Luker373/OST/CAD_Files/PotFitPieceCheapV3.SLDPRT

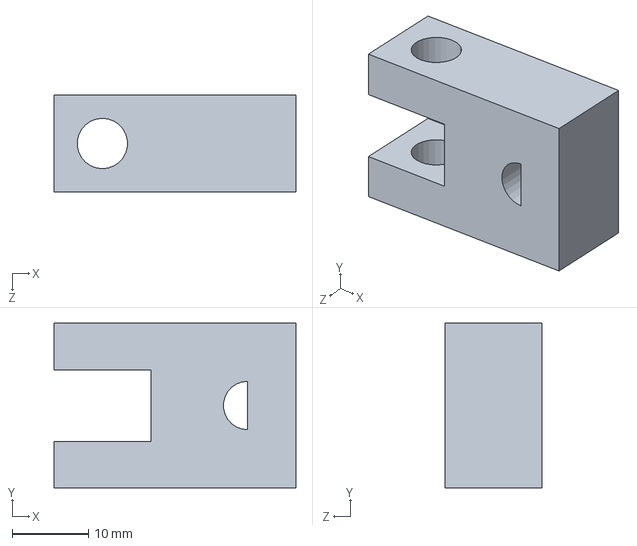
[picture p56: CAD file, 2019-04-29]
CAD_Files/PotFitPieceCheapV3.SLDPRT
31.8 x 21.6 x 12.7 mm
