Luker373/OST/CAD_Files/BoomSlotPieceConstrained.SLDPRT

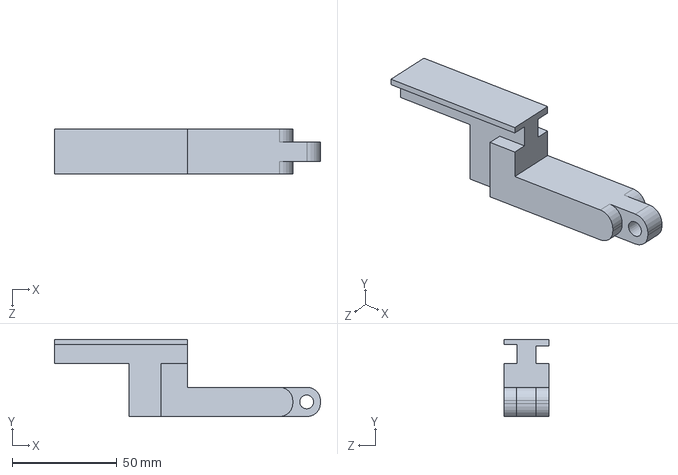
[picture p57: CAD file, 2019-04-29]
CAD_Files/BoomSlotPieceConstrained.SLDPRT
127.0 x 36.8 x 21.6 mm
