Luker373/OST/CAD_Files/HalfMastMountRedoArc.SLDPRT

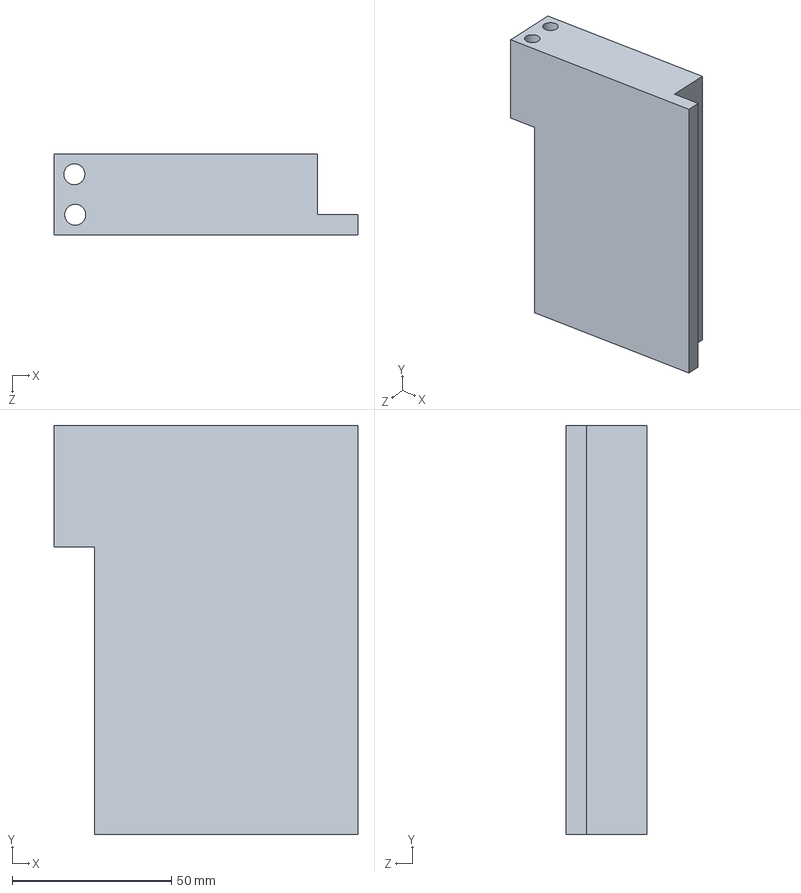
[picture p58: CAD file, 2019-02-09]
CAD_Files/HalfMastMountRedoArc.SLDPRT
95.2 x 128.3 x 25.4 mm
