Luker373/OST/CAD_Files/BoomHingePieceConstrained.SLDPRT

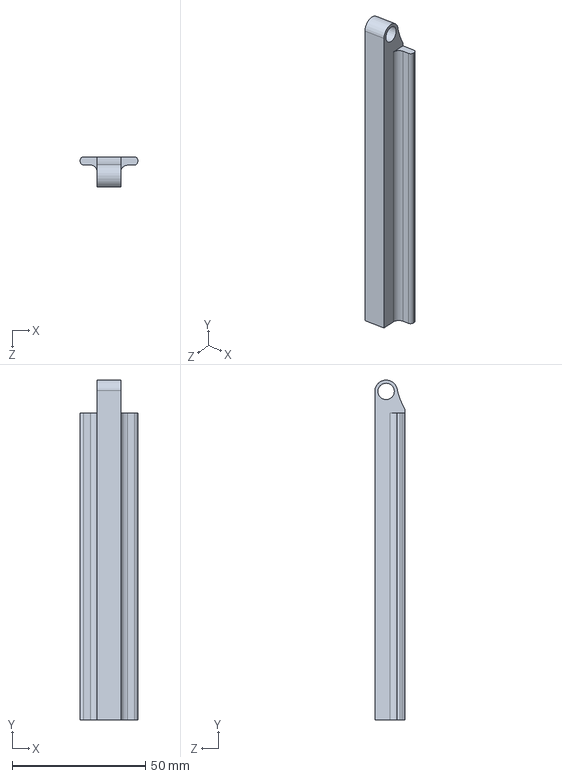
[picture p59: CAD file, 2019-02-08]
CAD_Files/BoomHingePieceConstrained.SLDPRT
21.6 x 127.5 x 11.4 mm
