Luker373/OST/CAD_Files/PotBoomRotTransferPartConstrained.SLDPRT

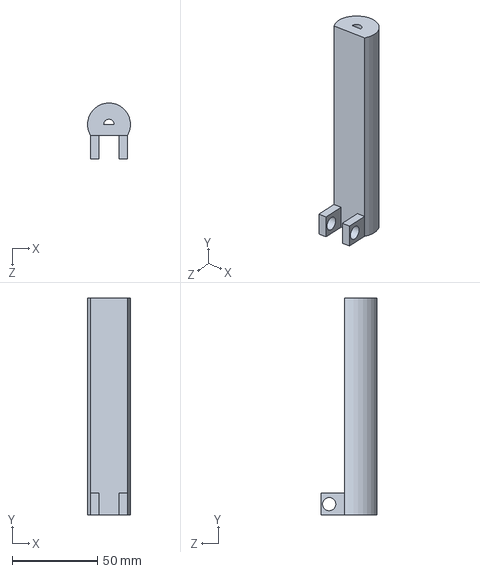
[picture p60: CAD file, 2019-02-08]
CAD_Files/PotBoomRotTransferPartConstrained.SLDPRT
25.1 x 127.3 x 32.7 mm
