Luker373/OST/CAD_Files/HalfMastMountV1.SLDPRT

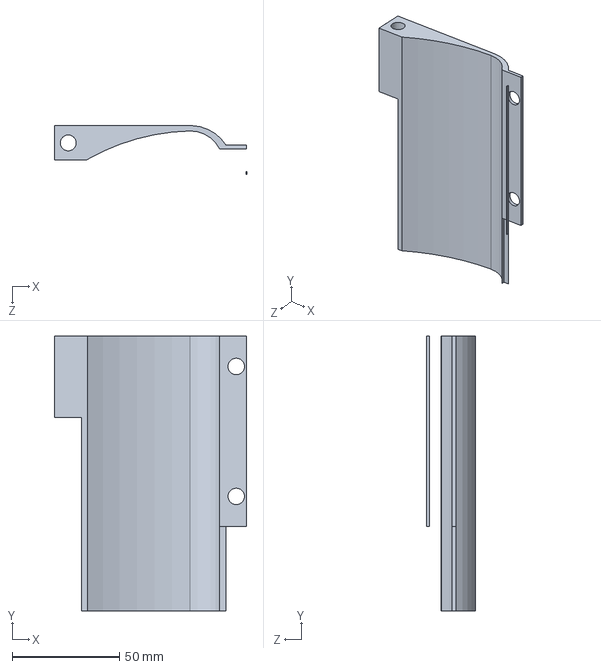
[picture p61: CAD file, 2019-02-07]
CAD_Files/HalfMastMountV1.SLDPRT
89.7 x 128.3 x 22.7 mm
