Luker373/OST/CAD_Files/PotBoomRotTransferPartV2.SLDPRT

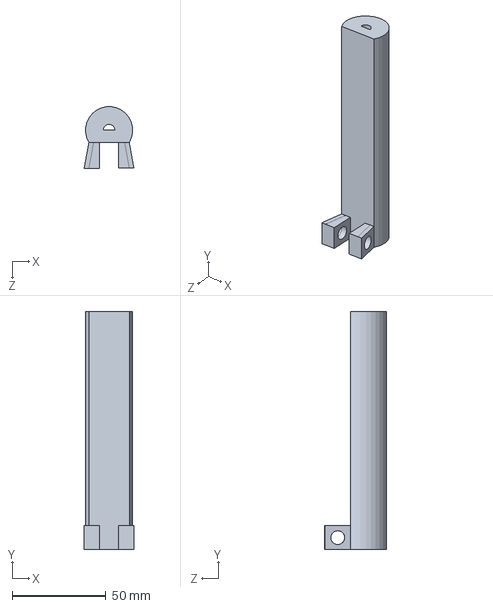
[picture p62: CAD file, 2019-01-29]
CAD_Files/PotBoomRotTransferPartV2.SLDPRT
26.6 x 127.3 x 32.9 mm
