Luker373/OST/CAD_Files/MastMountV2.SLDPRT

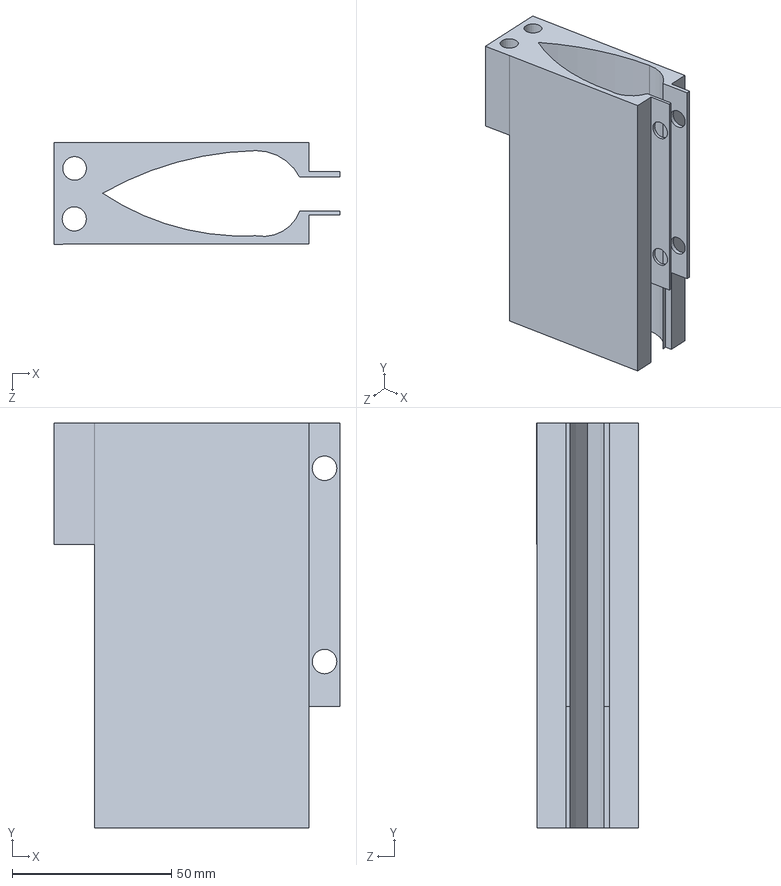
[picture p63: CAD file, 2019-01-29]
CAD_Files/MastMountV2.SLDPRT
89.7 x 127.0 x 31.9 mm
