Luker373/OST/CAD_Files/BoomHingePieceV2.SLDPRT

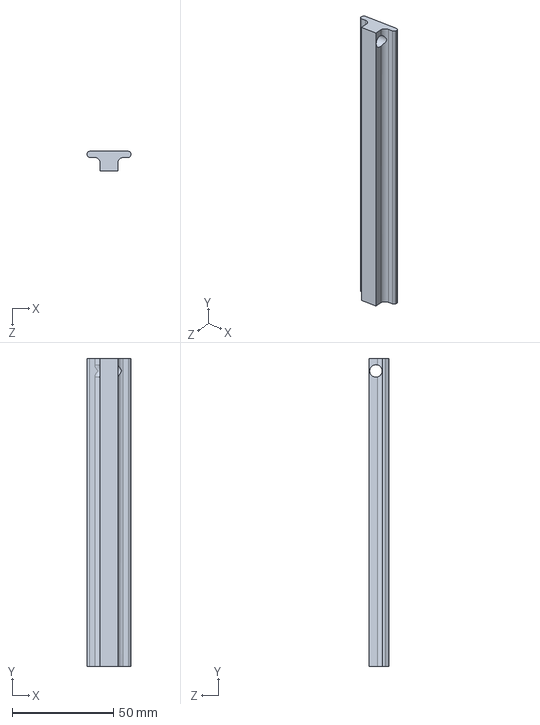
[picture p64: CAD file, 2019-01-29]
CAD_Files/BoomHingePieceV2.SLDPRT
21.6 x 152.4 x 9.67 mm
