Luker373/OST/CAD_Files/MastMountAirfoilPart.SLDPRT

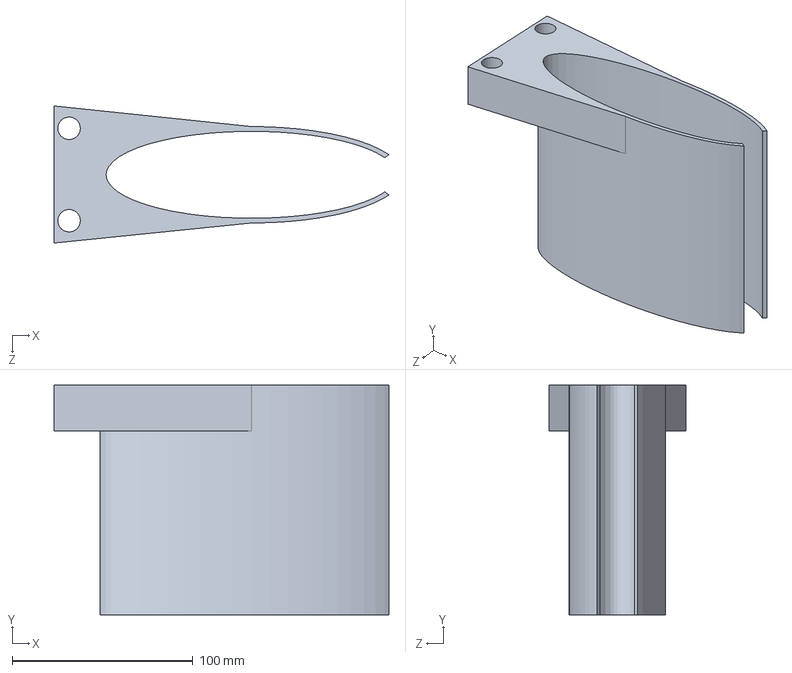
[picture p65: CAD file, 2019-01-22]
CAD_Files/MastMountAirfoilPart.SLDPRT
185.5 x 127.3 x 75.9 mm
