Luker373/OST/CAD_Files/MastMountFlatPart.SLDPRT

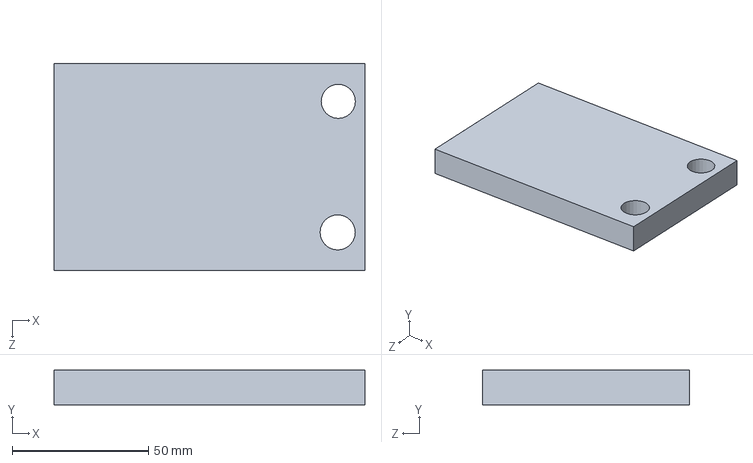
[picture p66: CAD file, 2019-01-22]
CAD_Files/MastMountFlatPart.SLDPRT
114.3 x 12.7 x 76.1 mm
