Luker373/OST/CAD_Files/BoomHingePiece.SLDPRT

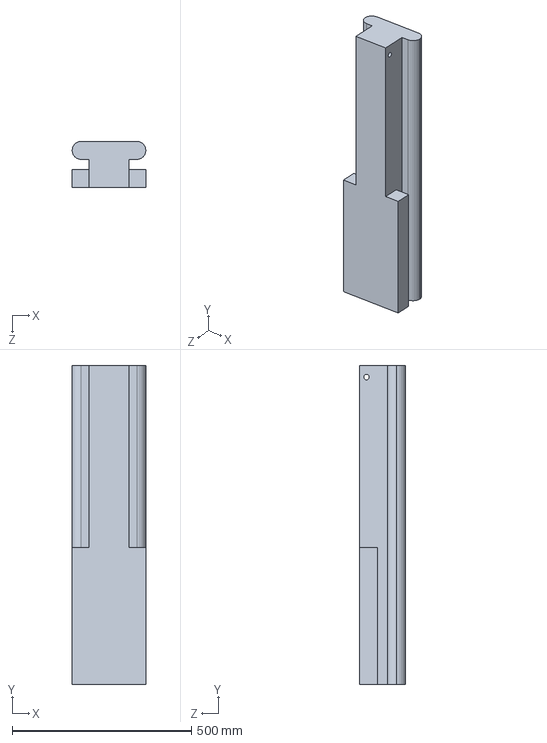
[picture p67: CAD file, 2019-01-25, an earlier design]
CAD_Files/BoomHingePiece.SLDPRT
205.8 x 889.5 x 129.5 mm
