Luker373/OST/CAD_Files/PotBoomRotTransferPart.SLDPRT

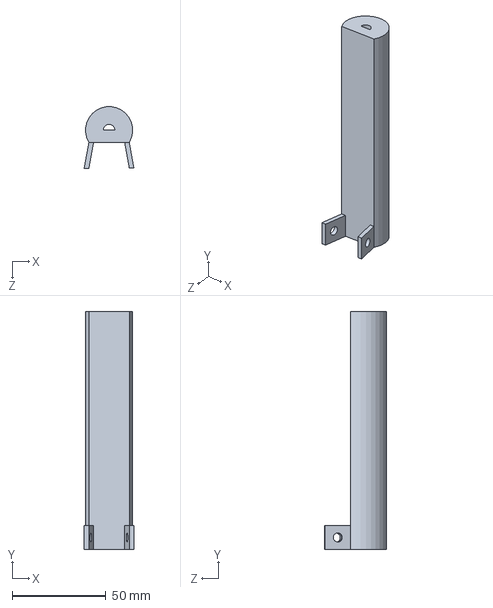
[picture p68: CAD file, 2019-01-22, an earlier design]
CAD_Files/PotBoomRotTransferPart.SLDPRT
26.6 x 127.3 x 32.9 mm
