Luker373/OST/CAD_Files/MastMountV1.SLDPRT

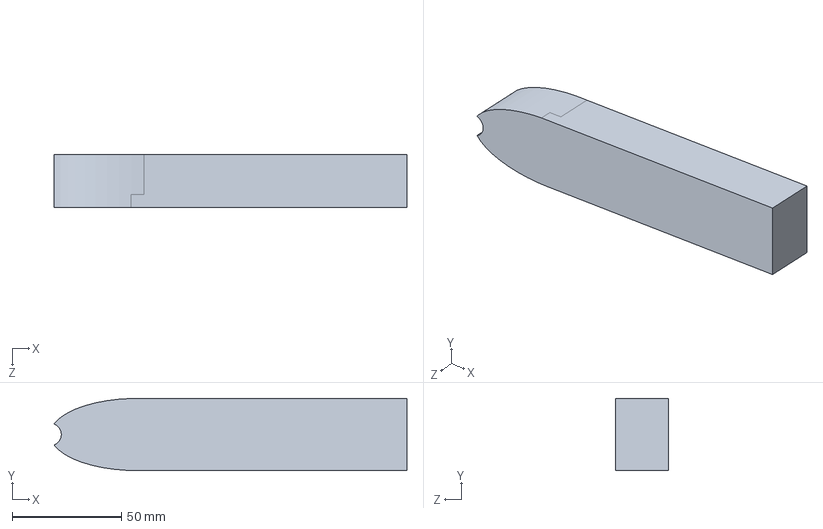
[picture p69: CAD file, 2019-01-18, an earlier design]
CAD_Files/MastMountV1.SLDPRT
161.8 x 33.1 x 24.1 mm
