Luker373/OST/MPLABXProjects/mast_pkg.X/src/AD.c

/*
 * File:   AD.c
 * Author: mdunne
 *
 * Created on November 22, 2011, 8:57 AM
 */

#include <xc.h>
#include "BOARD.h"
#include "AD.h"

#include <peripheral/adc10.h>
#include <peripheral/ports.h>
#include <peripheral/power.h>

#include <serial.h>

#include <stdio.h>

/*******************************************************************************
 * PRIVATE #DEFINES                                                            *
 ******************************************************************************/

//#define AD_DEBUG_VERBOSE


#define NUM_AD_PINS 6
#define NUM_AD_PINS_UNO 16


//#define AD_DEBUG_VERBOSE
#ifdef AD_DEBUG_VERBOSE
#include "serial.h"
#define dbprintf(...) while(!IsTransmitEmpty()); printf(__VA_ARGS__)
#else
#define dbprintf(...)
#endif



#define ALLADPINS (AD_A0|AD_A1|AD_A2|AD_A3|AD_A4|AD_A5)




/*******************************************************************************
 * PRIVATE VARIABLES                                                            *
 ******************************************************************************/
static unsigned int AD1PCFG_MASKS[NUM_AD_PINS] = {ENABLE_AN2_ANA, ENABLE_AN4_ANA,
    ENABLE_AN8_ANA, ENABLE_AN10_ANA, ENABLE_AN12_ANA, ENABLE_AN14_ANA};

static unsigned int AD1CSSL_MASKS[NUM_AD_PINS] = {SKIP_SCAN_AN2, SKIP_SCAN_AN4,
    SKIP_SCAN_AN8, SKIP_SCAN_AN10, SKIP_SCAN_AN12, SKIP_SCAN_AN14};

static unsigned int AD1PCFG_POS[NUM_AD_PINS] = {_AD1PCFG_PCFG2_POSITION, _AD1PCFG_PCFG4_POSITION,
    _AD1PCFG_PCFG8_POSITION, _AD1PCFG_PCFG10_POSITION, _AD1PCFG_PCFG12_POSITION, _AD1PCFG_PCFG14_POSITION};


static unsigned int ActivePins;
static unsigned int PinsToAdd;
static unsigned int PinsToRemove;
static unsigned int PinCount;
static unsigned int ADValues[NUM_AD_PINS];
static int PortMapping[NUM_AD_PINS];

static char ADActive;
static char ADNewData = FALSE;



/*******************************************************************************
 * PRIVATE FUNCTION PROTOTYPES                                                            *
 ******************************************************************************/
char AD_SetPins(void);

/*******************************************************************************
 * PUBLIC FUNCTIONS                                                           *
 ******************************************************************************/

/**
 * @function AD_Init(void)
 * @param None
 * @return SUCCESS or ERROR
 * @brief Initializes the A/D subsystem and enable battery voltage monitoring
 * @author Max Dunne, 2013.08.10 */
char AD_Init(void)
{

    if (ADActive) {
        return ERROR;
    }
    int pin = 0;
    //ensure that the battery monitor is active
	ADActive = TRUE;
    AD_SetPins();
    for (pin = 0; pin < NUM_AD_PINS; pin++) {
        ADValues[pin] = -1;
    }
    INTEnable(INT_AD1, INT_DISABLED);
    INTClearFlag(INT_AD1);
    INTSetVectorPriority(INT_ADC_VECTOR, 1);
    INTSetVectorSubPriority(INT_ADC_VECTOR, 3);
    INTEnable(INT_AD1, INT_ENABLED);
    EnableADC10();
    ADNewData = FALSE;
    //wait for first reading to ensure  battery monitor starts in the right spot
    while (!AD_IsNewDataReady()) {
#ifdef AD_DEBUG_VERBOSE
        PutChar('.');
#endif
    }
    //set the first values for the battery monitor filter

    return SUCCESS;
}

/**
 * @function AD_AddPins(unsigned int AddPins)
 * @param AddPins - Use #defined AD_XX OR'd together for each A/D Pin you wish to add
 * @return SUCCESS OR ERROR
 * @brief Remove pins from the A/D system.  If any pin is not active it returns an error
 * @author Max Dunne, 2013.08.15 */
char AD_AddPins(unsigned int AddPins)
{
    if (!ADActive) {
        dbprintf("%s called before enable\r\n", __FUNCTION__);
        return ERROR;
    }
    if ((AddPins == 0) || (AddPins > ALLADPINS)) {
        dbprintf("%s returning ERROR with pins outside range: %X\r\n", __FUNCTION__, AddPins);
        return ERROR;
    }
    if (ActivePins & AddPins) {
        dbprintf("%s Returning ERROR for pins already in state: %X \r\n", __FUNCTION__, AddPins);
        return ERROR;
    }
    //setting the pins to be added during the next interrupt cycle
    PinsToAdd |= AddPins;
    return SUCCESS;
}

/**
 * @function AD_RemovePins(unsigned int RemovePins)
 * @param RemovePins - Use #defined AD_XX OR'd together for each A/D Pin you wish to remove
 * @return SUCCESS OR ERROR
 * @brief Remove pins from the A/D system. If any pin is not active it returns an error
 * @author Max Dunne, 2013.08.15 */
char AD_RemovePins(unsigned int RemovePins)
{
    if (!ADActive) {
        dbprintf("%s called before enable\r\n", __FUNCTION__);
        return ERROR;
    }
    if ((RemovePins == 0) || (RemovePins > ALLADPINS)) {
        dbprintf("%s returning ERROR with pins outside range: %X\r\n", __FUNCTION__, RemovePins);
        return ERROR;
    }
    if (!(ActivePins & RemovePins)) {
        dbprintf("%s Returning ERROR for pins already in state: %X \r\n", __FUNCTION__, RemovePins);
        return ERROR;
    }

    //setting the pins to be added during the next interrupt cycle
    PinsToRemove |= RemovePins;
    return SUCCESS;
}

/**
 * @function AD_ActivePins(void)
 * @param None
 * @return Listing of all A/D pins that are active
 * @brief Returns a variable of all active A/D pins. An individual pin can be determined if
 *        active by "anding" with the AD_PORTXX Macros.
 * @note This will not reflect changes made with AD_AddPins or AD_RemovePins until the next A/D
 *       interrupt cycle.
 * @author Max Dunne, 2013.08.15 */
unsigned int AD_ActivePins(void)
{
    return ActivePins;
}

/**
 * @function AD_IsNewDataReady(void)
 * @param None
 * @return TRUE or FALSE
 * @brief This function returns a flag indicating that the A/D has new values since the last
 *        read of a value
 * @author Max Dunne, 2013.08.15 */
char AD_IsNewDataReady(void)
{
    if (ADNewData) {
        ADNewData = FALSE;
        return TRUE;
    }
    return FALSE;
}

/**
 * @function AD_ReadADPin(unsigned int Pin)
 * @param Pin - Used #defined AD_XX to select pin
 * @return 10-bit AD Value or ERROR
 * @brief Reads current value from buffer for given pin
 * @author Max Dunne, 2011.12.10 */
unsigned int AD_ReadADPin(unsigned int Pin)
{
    if (!ADActive) {
        dbprintf("%s returning ERROR before enable\r\n", __FUNCTION__);
        return ERROR;
    }
    if (!(ActivePins & Pin)) {
        dbprintf("%s returning error with unactivated pin: %X %X\r\n", __FUNCTION__, Pin);
        return ERROR;
    }
    unsigned char TranslatedPin = 0;
    while (Pin > 1) {

        Pin >>= 1;
        TranslatedPin++;
    }
    return ADValues[PortMapping[TranslatedPin]];
}

/**
 * @function AD_End(void)
 * @param None
 * @return None
 * @brief Disables the A/D subsystem and release the pins used
 * @author Max Dunne, 2013.09.20 */
void AD_End(void)
{
    int pin;
    if (!ADActive) {
        return;
    }
    INTEnable(INT_AD1, INT_DISABLED);
    AD1CON1CLR = _AD1CON1_ON_MASK;
    PinsToRemove = ALLADPINS;
    AD_SetPins();
    for (pin = 0; pin < NUM_AD_PINS; pin++) {
        ADValues[pin] = -1;
    }
    ActivePins = 0;
    PinCount = 0;
    //CloseADC10();    
    AD1PCFG = 0xFF;
}

/*******************************************************************************
 * PRIVATE FUNCTIONS                                                       *
 ******************************************************************************/

/**
 * @function AD_SetPins(void)
 * @param None
 * @return SUCCESS OR ERROR
 * @brief Connects pins in PinstoAdd to the A/D system and removes the pins in PinsToRemove
 * @note Private Function. DO NOT USE.
 * @author Max Dunne, 2013.08.15 */
char AD_SetPins(void)
{
    if (!ADActive) {
        return ERROR;
    }
    unsigned int cssl = 0;
    unsigned int pcfg = 0;
    unsigned int rempcfg = 0;
    unsigned char CurPin = 0;
    unsigned int CurPinOrder = 0x00;
    int ADMapping[NUM_AD_PINS_UNO];
    AD1CON1CLR = _AD1CON1_ON_MASK; //disable A/D system and interrupt
    INTEnable(INT_AD1, INT_DISABLED);
    PinCount = 0;

    //determine the new set of active pins
    ActivePins |= PinsToAdd;
    ActivePins &= ~PinsToRemove;
    //initialize the mapping array to -1
    for (CurPin = 0; CurPin < NUM_AD_PINS_UNO; CurPin++) {
        ADMapping[CurPin] = -1;
    }
    // memset(ADMapping,-1,NUM_AD_PINS_UNO);
    for (CurPin = 0; CurPin < NUM_AD_PINS; CurPin++) {
        PortMapping[CurPin] = -1; //reset all ports to unmapped
        if ((ActivePins & (1 << CurPin)) != 0) { //if one of the pins is active
            //build masks and remap pins
            cssl |= AD1CSSL_MASKS[CurPin];
            pcfg |= AD1PCFG_MASKS[CurPin];
            ADMapping[AD1PCFG_POS[CurPin]] = CurPin;
            PinCount++;
        }
        if ((PinsToRemove & (1 << CurPin)) != 0) {//generate removal masks
            rempcfg |= AD1PCFG_MASKS[CurPin];
        }
    }
    for (CurPin = 0; CurPin < NUM_AD_PINS_UNO; CurPin++) {//translate AD Mapping to Port Mapping
        if (ADMapping[CurPin] != -1) {
            PortMapping[ADMapping[CurPin]] = CurPinOrder;
            CurPinOrder++;
        }
    }
    cssl = ~cssl;
    OpenADC10(ADC_MODULE_ON | ADC_FORMAT_INTG | ADC_CLK_AUTO | ADC_AUTO_SAMPLING_ON,
            ADC_VREF_AVDD_AVSS | ADC_SCAN_ON | ((PinCount - 1) << _AD1CON2_SMPI_POSITION) | ADC_BUF_16,
            ADC_SAMPLE_TIME_29 | ADC_CONV_CLK_51Tcy2 | ADC_CONV_CLK_PB, pcfg, cssl);
    AD1PCFGSET = rempcfg;
    //recalculate interval between battery samples
    PinsToAdd = 0;
    PinsToRemove = 0;
    INTEnable(INT_AD1, INT_ENABLED);
    return SUCCESS;
}

/**
 * @function ADCIntHandler
 * @param None
 * @return None
 * @brief Interrupt Handler for A/D. Reads all used pins into buffer.
 * @note This function is not to be called by the user
 * @author Max Dunne, 2013.08.25 */
void __ISR(_ADC_VECTOR, ipl1auto) ADCIntHandler(void)
{
    unsigned char CurPin = 0;
    INTClearFlag(INT_AD1);
    for (CurPin = 0; CurPin <= PinCount; CurPin++) {
        ADValues[CurPin] = ReadADC10(CurPin); //read in new set of values
    }
    //calculate new filtered battery voltage

    //if pins are changed add pins
    if (PinsToAdd | PinsToRemove) {
        AD_SetPins();
    }
    ADNewData = TRUE;
}





//#define AD_TEST
#ifdef AD_TEST
//pragmas are to set up the clock the same as it will be when using the ds30, once ds30 is up they should not be invoked
#pragma config FPLLIDIV 	= DIV_2		//PLL Input Divider
#pragma config FPLLMUL 		= MUL_20	//PLL Multiplier
#pragma config FPLLODIV 	= DIV_1 	//System PLL Output Clock Divid
#pragma config FNOSC 		= PRIPLL	//Oscillator Selection Bits
#pragma config FSOSCEN 		= OFF		//Secondary Oscillator Enable
#pragma config IESO 		= OFF		//Internal/External Switch O
#pragma config POSCMOD 		= XT		//Primary Oscillator Configuration
#pragma config OSCIOFNC 	= OFF		//CLKO Output Signal Active on the OSCO Pin
#pragma config FPBDIV 		= DIV_2		//Peripheral Clock Divisor
#pragma config FCKSM 		= CSECMD	//Clock Switching and Monitor Selection
#pragma config WDTPS 		= PS1		//Watchdog Timer Postscaler
#pragma config FWDTEN		= OFF		//Watchdog Timer Enable
#pragma config ICESEL		= ICS_PGx2	//ICE/ICD Comm Channel Select
#pragma config PWP 			= OFF		//Program Flash Write Protect
#pragma config BWP 			= OFF		//Boot Flash Write Protect bit
#pragma config CP 			= OFF		//Code Protect


//#pragma FPBDIV                  = DIV_2  //Peripheral clock, unsure why it is not included in the ds30 settings



#include <xc.h>
#include "serial.h"
#include "AD.h"
#include <stdio.h>

#define DELAY(x)         for (wait = 0; wait <= x; wait++) {asm("nop");}
//#define DISABLE_ADINIT
#define TIMES_TO_READ 4000

#define ODD_ACTIVE (AD_A1|AD_A3|AD_A5)
#define EVEN_ACTIVE (AD_A0|AD_A2|AD_A4)

#define ALLADMINUSBATT ALLADPINS 

//#define ADPinHasChanged(PinsAdded)

int main(void)
{
    unsigned int wait = 0;
    int readcount = 0;
    unsigned int CurPin = 0;
    unsigned int PinListing = 0;
    char FunctionResponse = 0;
    char TestFailed = FALSE;
    //SERIAL_Init();
    //INTEnableSystemMultiVectoredInt();
    BOARD_Init();
    mJTAGPortEnable(0);
 //MAXL:  MOVE THIS TO END AND FIX THE REST OF THIS TEST CODE
    while(1){
        printf("idling....waiting for sleep test\n");
        while (!IsTransmitEmpty());
    }
    //END MAXL
    printf("\r\nUno A/D Test Harness\r\nThis will initialize all A/D pins and read them %d times\r\n", TIMES_TO_READ);
    //printf("Value of pcfg before test: %X\r\n", AD1PCFG);
    // while(!IsTransmitEmpty());
    //AD_Init(BAT_VOLTAGE);
    //AD_Init();
    printf("Testing functionality before initialization\r\n");

    /*adding pins individually */
    printf("AD_AddPins on each pin indvidually which results in failure: ");
    for (CurPin = 1; CurPin < ALLADPINS; CurPin <<= 1) {
        FunctionResponse = AD_AddPins(CurPin);
        if (FunctionResponse != ERROR) {
            TestFailed = TRUE;
            break;
        }
    }
    if (TestFailed) {
        printf("FAIL\r\n");
    } else {
        printf("PASSED\r\n");
    }
    TestFailed = FALSE;
    /*removing pins individually*/
    printf("AD_RemovePins on each pin indvidually which results in failure: ");
    for (CurPin = 1; CurPin < ALLADPINS; CurPin <<= 1) {
        FunctionResponse = AD_RemovePins(CurPin);
        if (FunctionResponse != ERROR) {
            TestFailed = TRUE;
            break;
        }
    }
    if (TestFailed) {
        printf("FAIL\r\n");
    } else {
        printf("PASSED\r\n");
    }
    TestFailed = FALSE;
    /*listing pins while inactive*/
    printf("AD_ActivePins which should return 0: ");
    PinListing = AD_ActivePins();
    if (PinListing != 0x0) {
        printf("FAILED\r\n");

    } else {
        printf("PASSED\r\n");
    }
    //    /*calling ned when inactive*/
    //        printf("AD_End which should fail: ");
    //        FunctionResponse = AD_End();
    //        if (FunctionResponse != ERROR) {
    //            printf("FAILED\r\n");
    //        } else {
    //            printf("PASSED\r\n");
    //        }
    /*activating module*/
    printf("initializing using AD_Init: ");
    FunctionResponse = AD_Init();
    if (FunctionResponse != SUCCESS) {
        printf("FAILED\r\n");
    } else {
        printf("PASSED\r\n");
    }
    /*attempting to reactivate*/
    printf("initializing using AD_Init again returns error: ");
    FunctionResponse = AD_Init();
    if (FunctionResponse != ERROR) {
        printf("FAILED\r\n");
    } else {
        printf("PASSED\r\n");
    }
    /*each pin added should succeed*/
    printf("Adding each pin using AD_AddPins indivdually: ");
    for (CurPin = 1; CurPin < ALLADMINUSBATT; CurPin <<= 1) {
        PinListing = AD_ActivePins();
        FunctionResponse = AD_AddPins(CurPin);
        if (FunctionResponse != SUCCESS) {
            TestFailed = TRUE;
            break;
        }
        while (AD_ActivePins() != (PinListing | CurPin));
    }
    if (TestFailed) {
        printf("FAIL\r\n");
    } else {
        printf("PASSED\r\n");
    }
    /*removing each pin should succeed */
    printf("Removing each pin using AD_RemovePins indivdually: ");
    for (CurPin = 1; CurPin < ALLADMINUSBATT; CurPin <<= 1) {
        PinListing = AD_ActivePins();
        FunctionResponse = AD_AddPins(CurPin);
        if (FunctionResponse != SUCCESS) {
            TestFailed = TRUE;
            break;
        }
        while (AD_ActivePins() != (PinListing | CurPin));
    }
    if (TestFailed) {
        printf("FAIL: %X\r\n", 0xFEED);
    } else {
        printf("PASSED\r\n");
    }
    while (1);
    printf("We will now add the odd pins and wait for them to be activated");
    AD_AddPins(ODD_ACTIVE);
    while (!(AD_ActivePins() & ODD_ACTIVE)) {
        if (IsTransmitEmpty()) {
            printf("%X\r\n", AD_ActivePins());
        }
    }
    printf("The Odd pins are now active as shown by Active pins: %X\r\n", AD_ActivePins());
    printf("We will now enable the even pins and wait for them to be activated");
    AD_AddPins(EVEN_ACTIVE);
    while (!(AD_ActivePins() & EVEN_ACTIVE));
    printf("The Even pins are now active as shown by Active pins: %X\r\n", AD_ActivePins());


    char numtoread = NUM_AD_PINS;
    unsigned char cur = 0;
    DELAY(400000)
    while (readcount <= TIMES_TO_READ) {
        DELAY(100000);
        printf("\r\n");
        for (cur = 0; cur < numtoread; cur++) {
            printf("%d\t", AD_ReadADPin(1 << cur));
        }
        printf("\r\n");
        readcount++;
    }
    printf("Done Reading Them\r\n");
    AD_End();
    printf("Value of pcfg after test: %X", AD1PCFG);

    return 0;
}
#endif
