Luker373/OST/(commit log)

2019-01-18 Upload New File
    [MastMountFlatPart.SLDPRT]
2019-01-18 Replace MastMountFlatPart.SLDPRT: adding holes for threads to connect with mast mount
    [MastMountFlatPart.SLDPRT]
2019-01-19 Some git setup stuff
    [MastMountFlatPart.SLDPRT, MastMountV1.SLDPRT]
2019-01-22 Replace MastMountFlatPart.SLDPRT: added holes, need to make threads (?)
    [MastMountFlatPart.SLDPRT]
2019-01-22 Replace MastMountAirfoilPart.SLDPRT
    [MastMountAirfoilPart.SLDPRT]
2019-01-25 Replace BoomHingePiece.SLDPRT: adjusted position of fastener hole (lower), added secondary block section for half of length to provide snug fit on boom w/o hindering rotation
    [BoomHingePiece.SLDPRT]
2019-01-29 Upload New File: made boom hinge piece match dimensions of quest, fit into slot, has hole for bolt
    [BoomHingePieceV2.SLDPRT]
2019-01-29 Upload New File: issues with approximating airfoil shape, flexibility of material unknown. will do fea on part later to see what stresses can be handled.
    [MastMountV2.SLDPRT]
2019-01-29 Upload New File: edited to be more flush with the boom connection arm
    [PotBoomRotTransferPartV2.SLDPRT]
2019-02-07 Replace HalfMastMountV1.STL
    [HalfMastMountV1.STL]
2019-03-01 modified LSMbase code to working with gyroZ, I2C_ReadInt(), and FALSE, for little endian
2019-04-29 added updated horizontal link and rotation transfer piece for BA sensor
    [BoomSlotPieceConstrained.SLDPRT, HalfMastMountRedoArc(outdated).SLDPRT, HalfMastMountV1(outdated).SLDPRT, MastMountAirfoilPart(outdated).SLDPRT, PotFitPieceCheapV3.SLDPRT]
2019-06-27 moving files around
    [BoomHingePieceV2.STL, BoomToPotRotationHinge.SLDASM, HalfMastMountV1.STL, PotBoomRotTransferPartV2.STL]
